nachoodiaz31508-dot/FrontEndMediClock/(commit log)

2026-09-30 feat(firmware): scaffold ESP32 mediclock base sin botones
2026-09-30 docs(odd): registra convencion español didactico para firmware
2026-10-01 feat(firmware): T6 integracion final, fix define LCD y docs
    [config.h, nuevo_mediclock_ino.ino]
2026-10-01 feat: nombre de paciente y alias de dispositivo solo-front
    Titulo principal muestra el nombre del paciente editable, persistido en
    localStorage; el dispositivo acepta un alias local por dispositivoId sin
    llamar al PUT del backend y conserva el nombre real como secundario.
2026-10-01 feat: rediseno alarmas en dos columnas con formulario amable
    Boton celeste colapsable con formulario compartido crear/editar a la
    izquierda y lista compacta a la derecha (apilado en mobile). El dia se
    elige por nombre Lunes a Domingo y la hora con selector type=time que
    se convierte a HH:mm:ss al enviar; validaciones y 409 amable intactos.
2026-10-01 feat: alias en selector y editor de paciente colapsable
2026-10-01 docs(firmware): etiquetas DEVKIT V1 y diagrama de cableado
2026-10-01 config(firmware): URL publica del back para prototipo
2026-10-02 fix(firmware): compatibilidad nucleo ESP32 v3 y RTC DS1302
    [config.h, nuevo_mediclock_ino.ino]
2026-10-02 fix(firmware): parsear hora como texto antes que numero
    [nuevo_mediclock_ino.ino]
2026-10-02 fix(firmware): POST evento con modelo Evento del back
    [config.h, nuevo_mediclock_ino.ino]
